wagiminator/ATtiny13-TinyTacho/hardware/TinyTacho_BOM_v1.1.tsv

ID | Name | Designator | Footprint | Quantity | Manufacturer Part | Manufacturer | Supplier | Supplier Part | LCSC Assembly
1 | MSK-11027 | KEY1 | SW_SMD_MSK-11027 | 1 | MSK-11027 Toggle Switches | ReliaPro | LCSC | C21381
2 | OLED 0.91 | OLED1 | I2C OLED 0.91 | 1 | SSD1306 I2C OLED
3 | 10k | R3,R1 | 0603 | 2 | 0603WAF1002T5E | UniOhm | LCSC | C25804
4 | 100R | R2 | 0603 | 1 | 0603WAF1000T5E | UniOhm | LCSC | C22775
5 | ATtiny13A | U6 | SOP-8_150MIL | 1 | ATTINY85-20SU | MICROCHIP | LCSC | C89852
6 | 100n | C3,C1 | 0603 | 2 | CC0603KRX7R9BB104 | YAGEO | LCSC | C14663
7 | 47u | C2 | 1206 | 1 | 1206F476M160NT | FH | LCSC | C30300
8 | 10k | R4 | TC33X | 1 | TC33X-2-103E | BOURNS | LCSC | C719176
9 | EXT | H1 | HEADER_2X1 | 1 | 826629-2 | TE Connectivity | LCSC | C86471
10 | IR PHOTO DIODE | LED2 | PD-3MM/2.54 | 1 | Generic
11 | IR LED | LED1 | LED-3MM/2.54 | 1 | Generic
12 | LIR1220 | B1 | CR1220-SMD | 1
