wagiminator/ATtiny13-TinyTacho/hardware/TinyTacho_schematic_v1.1.pdf

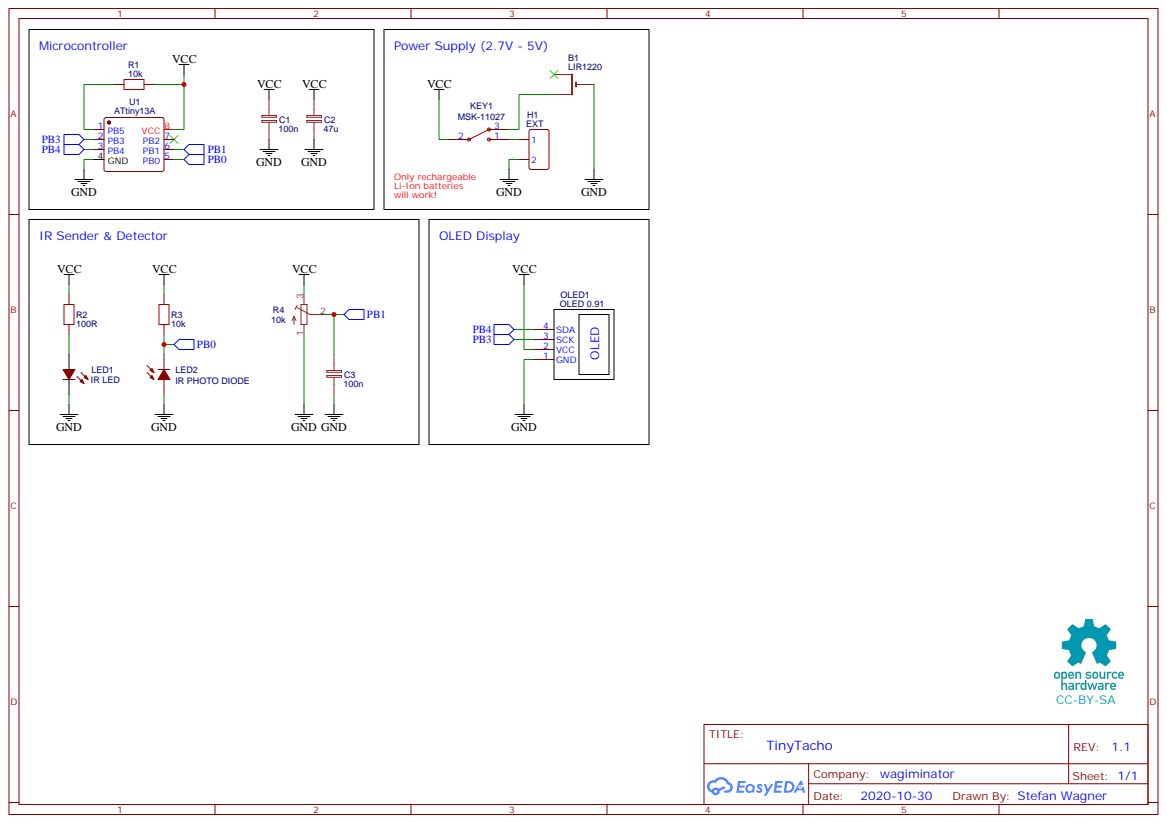
[picture p11: page 1]

Drawn By: Stefan Wagner
