wagiminator/ATtiny13-TinyTacho/hardware/TinyTacho_schematic_v1.0.pdf

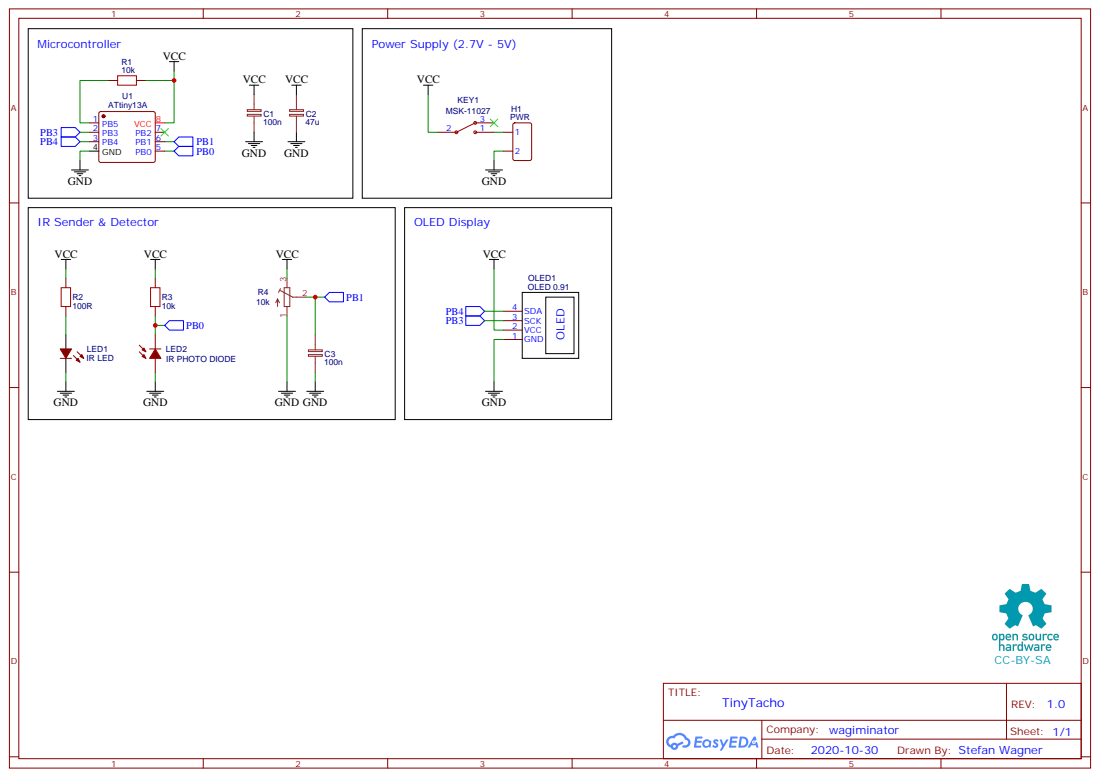
[picture p12: page 1]

Drawn By: Stefan Wagner
